VzBoT3D/VzBoT-Vz235/README.md

# VzBoT-Vz235

The Vz-235 is a smaller sized VzBoT with a bed print size of 235 x 235 and a Z of 200-225 mm depending on your hotend length and an optional AWD setup, for which we named the Kinematics "QuadXY" (also known as AWD).

You can find the complete web model without CAD-Software here:

- [Printed Vz-235](https://a360.co/4ig13Yv)
- [CNC Full Mellow kit](https://a360.co/3DxAVt8) 

## Purchase

AWD kit by Mellow3D: [Mellow Genuine DIY VzBoT AWD 235 VZ235 3D Printer Kit](https://s.click.aliexpress.com/e/_DldJGNB)

The AWD version has been proven to be great for high speed printing without loss of quality!

VZ_235_QuadXY

## Support

Discord Invite (https://discord.gg/KWZWvCMxCq)

## License

This project is licensed as Creative Commons Attribution-NonCommercial 4.0 International (CC BY-NC 4.0)
(https://creativecommons.org/licenses/by-nc/4.0/)
