VzBoT3D/VzBoT-Vz235/Resellers/README.md

List of resellers (this will be updated as we will deploy elwhere)

## Europe:

## Europe:

- Danemark: [3DO.eu](https://3do.eu/) 
- Germany: [CR-3D.de](https://www.cr3d.de/)
- Germany: [Meltbro](https://meltbro.de)
- Poland: [X3Dshop](https://x3dshop.com/)

## Australia:
- [raven3dtech.com.au](https://raven3dtech.com.au)

## Canada:
- [Northprint3d.ca](https://northprint3d.ca/product/vzbot-mellow-goliath-lsd-hotend/)

## USA:
- [Provok3D](https://provok3d.com/vzbot-2/?v=0a10a0b3e53b)
- [3Dprintedprinter](https://3Dprintedprinters.com) 
- [Genericprinter](https://www.genericprinter.com/)
- [Print3Dshop.org](https://print3dshop.org/)
- [Fabreeko](https://www.fabreeko.com/collections)

## More to come..
