VzBoT3D/VzBoT-Vz235/CAD/water pump-reservoir 150mm mount/README.md

BOM:

-8 x M4 12mm socket head
-4 x M4 Nut
-Elastic rope https://amzn.to/3NckYsY
- 150mm Water reservoir-pump kit Mellow: https://s.click.aliexpress.com/e/_DmlQsNr

  (Note that the 150mm might be unavailable, Mellow will add it back)

water_pump_mount_2023-Jun-21_02-46-15PM-000_CustomizedView52559326699
40250daa-644c-45b9-bb69-b60e7e664715
