VzBoT3D/VzBoT-Vz235/CAD/Screen Enclosure/Mellow-Fly Version/README.md

## Please note the USB-C port is not needed when connected with ribbon cable (DSI)



BOM:

- 4 x 6mm M3 bolts
- 1 x 25mm M4 bolts (for the hinge)
- 1 x M4 nut
- 2 x M4 8mm bolt (to bolt to frame)
- 2 M4 T-nuts
- Screen : https://s.click.aliexpress.com/e/_DDhO8jX
