VzBoT3D/VzBoT-Vz235/CAD/Pannels/Panels DXF/README.md

Panels for vz235 both AWD and 2WD, will work with both printed and alu parts
