VzBoT3D/VzBoT-Vz235/CAD/Electronic/Cam mounts/IMX179/README.md

BOM:

- 4 x M2.5 10mm
- 2 x M4 10mm
- 2 x M4 t-nuts
- Cam: https://www.welectron.com/Waveshare-USB-Camera-A-IMX179-8MP-HD-Embedded-Mic
