VzBoT3D/VzBoT-Vz235/Assemblies & STL/Electronics/Cam mount/HBVCAM-F20216HD/README.md

HBVCAM-F20216HD 2MP 
CAM [here](https://amzn.to/3bjp0RK) 

The Camera has a Field of View (FOV)：136°  ultra wide angle

Mainsail config: camera_usb_options="-r 1920x1080 -f 3 -q 100"

BOM: 4x M2 10mm + 2xM4 8mm + 2 tnuts 
