VzBoT3D/VzBoT-Vz235/CAD/Electronic/Cam mounts/Arducam UC-626/README.md

Arducam UC-626 with Sony 8MP IMX219
CAM [here](https://www.uctronics.com/camera-modules/usb-uvc-camera-module/arducam-8mp-1080p-usb-camera-module-1-4-cmos-imx219-mini-uvc-usb2-0-webcam-board-with-1-64ft-0-5m-usb-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) or [here](https://amzn.to/3O8LiDR) on Amazon Canada 

The Camera has a Field of View (FOV)：H=62.2°, V=48.8°  which is not ultra wide angle, so once you switch to 1080, its not wide enough. It works good with 720p, but still would be better with wider FOV

I suggest trying this one that should fit in same case. But cover might need to be redesigned for the front hole
https://www.uctronics.com/arducam-8mp-imx179-150-wide-angle-m12-lens-camera-module.html
