VzBoT3D/VzBoT-Vz235/Gallery/README.md

DSC05306 (Large)
DSC05307 (Large)
DSC05308 (Large)
DSC05309 (Large)
DSC05310 (Large)
DSC05311-Edit (Large)
DSC05313 (Large)
DSC05315 (Large)
DSC05316 (Large)
DSC05319 (Large)
DSC05320 (Large)
DSC05321 (Large)
DSC05322 (Large)
DSC05326 (Large)
DSC05331-Edit (Large)
DSC05332 (Large)
DSC05334 (Large)
DSC05339 (Large)
DSC05343 (Large)
DSC05344 (Large)
DSC05345 (Large)
DSC05346 (Large)
DSC05380 (Large)
DSC05381 (Large)
DSC05382 (Large)
DSC05383 (Large)

Vz235-gantry-printed
Vz235-gantry-printed
