VzBoT3D/VzBoT-Vz235/CAD/README.md

## Due to the large file sizes of .step files it is required to zip the files before uploading to github
After downloading the folder can be unpacked with 7-Zip (https://www.7-zip.org/)

For those not familiar with CAD software, we recommend using Fusion360 to open the step files
Do not feel intimidated by the sheer amount of parts or complexity
linked below are some video's to get started in Fusion360

https://www.youtube.com/watch?v=WBQFc_4rU18

https://www.youtube.com/watch?v=a5L55B5OCQM

https://www.youtube.com/watch?v=9Jgty4QDtss
