VzBoT3D/VzBoT-Vz235/Aluminum parts/README.md

# Aluminium parts 

## As available at https://f3d-racing-fdm.myshopify.com/collections/vzbot-vz235

Download the full manual, which includes BOM & print list for all aluminum goodness, above or download the per product manual

VZ-235_AWD gantry
