VzBoT3D/VzBoT-Vz235/Aluminum parts/Rear motormounts & Idlers AWD/README.md

# Rear motormounts/Idlers for AWD configuration

## ! for the AWD Idlers you will need misumi or comparable shoulder bolts with specific dimensions: 5mm diameter, 20mm length (shaft), 6mm M3 threading !

Correct shoulder bolts: https://nl.aliexpress.com/item/1005003611471729.html

the current (beta) units for this part as sold by F3D have the outer mounting hole intended for a M3 bolt instead of M4 like the mellow version (shown in picture)
this will be perfectly fine but be aware
