VzBoT3D/VzBoT-Vz235/Aluminum parts/Front motor mounts/README.md

# Front motor mounts for AWD and 2WD

For instructions, BOM and STL list: see the pdf manual above
