VzBoT3D/VzBoT-Vz235/Aluminum parts/Front motor mounts/STL's/readme.md

The printed motor anchor alu mount needs to be printed as it's imported
