VzBoT3D/VzBoT-Vz235/Assemblies & STL/Z-Assembly/parts to print 2 & 4 times/README.md

check the manual for the amount to print each part
