VzBoT3D/VzBoT-Vz235/Assemblies & STL/Gantry/Y gantry/Aluminum Y Gantry/BOM/README.md

# BOM is for one side only. You will need 2. 

### Your choice of precision shoulder bolts for Idlers, or M5 titanium or aluminum bolts with nuts. If you prefer weight saving go with bolts. If you prefer precision on idlers, go with shoulder bolts

## (Note: Since Carbon fiber tube dimensions are not always the same, you may need to add spacers (printed) between aluminum part and cabon tube. My tubes were 20.85mm and 20.65mm. I used the 20.85mm one with no washer. So depending on your luck, you may need to add spacers. See in the STL folder. you can scale it in Z in your slicer to fit your tube)

## When torquing the the idlers, make sure you do not apply to much axial load on the idler bearings. Tight manually with hands then add 1/4. Make sure idlers spin freely. This will avoid rattling sound, specially if you use graphite or metal spacers sold by mellow Kit)

(The below animation is from Vz330. Same instructions applies to Vz150 and 235, except for idlers orientation that is different. Smooth to the front and toothed to the back on the 150 and 235)
Y gantry aluminum v7

- (You might also take a look at this full gantry hardware kit https://s.click.aliexpress.com/e/_A0Qa7P)

| Quantity | Part | Comment | Image  | Links  |
| --- | ---- | --- | -----  | -----	|
| 4 | M3 10mm Bolts | | M3x10_sockethead	 | |
| 2 | M3 30mm Bolts | | M3x30_sockethead	 | |
| 2 | M3 Nuts | |	M3_Nut | |
| 2 | M5 30mm Bolts | Titanium | M5x30_sockethead  | https://s.click.aliexpress.com/e/_ABwfEB |
| 2 | M5 	  Nylon locking Nuts |	 | M5_Nylon_lock_Nut | |
| 2 | M4 Shoulder bolt 25mm + 2 M4 nuts| D5-M4 instead of the M5 Bolts. | | https://s.click.aliexpress.com/e/_DEXaIjF |
| 1 | 20teeth Gt2 pulley 5mm bore  | |Idler-20tooth GT2 6mm+5mm bore	 | https://s.click.aliexpress.com/e/_A79ECg |
| 1 | Noteeth Gt2 pulley 5mm bore  | |	 Idler-notooth GT2 6mm+5mm bore | https://s.click.aliexpress.com/e/_A79ECg |
| 1 | Aluminum Gantry | |	Alu gantry | https://s.click.aliexpress.com/e/_9Ghgwj |
