VzBoT3D/VzBoT-Vz235/BOM/README.md

# VzBoT-Vz235
# Work in progress, please tell us any errors
## https://docs.google.com/spreadsheets/d/1zm8jDL3NnV-vcbTjB-WAfdR3G6cT10QKlFqJNG42WAU/edit?usp=sharing

VZ_235_QuadXY
