VzBoT3D/VzBoT-Vz235/(list of files, cad)

Other CAD files:
Aluminum parts/Complete Z-system/STL-files/VZ_235_AWD_2WD_Z assembly allignment tool 10mm rods VZprinthead.stl
Assemblies & STL/Spool holder/main body.stl
Assemblies & STL/Z-Assembly/parts to print 2 & 4 times/upper rod mount main.stl
Assemblies & STL/Z-Assembly/parts to print 2 & 4 times/lower rod mount main.stl
Aluminum parts/Aluminium Y gantry/gantry_back_spacer.stl
Aluminum parts/Front motor mounts/STL's/left/printed standoff.stl
Aluminum parts/Front motor mounts/STL's/right/printed standoff.stl
Aluminum parts/Rear motormounts & Idlers AWD/STL's/spacer M3 corner.stl
Assemblies & STL/[Optional] Wall anchor/printer anchor frame side.stl
Assemblies & STL/CPAP turbo cooling system/STLs/CPAP back panel tube mount/optinal cap (need 18.2mm hole.stl
Assemblies & STL/CPAP turbo cooling system/STLs/CPAP Muffler/baffle.stl
Assemblies & STL/CPAP turbo cooling system/STLs/upper duct.stl
Assemblies & STL/Electronics/Cam mount/ArducamMount/enclosure.stl
Assemblies & STL/Electronics/Cam mount/HBVCAM-F20216HD/enclosure.stl
Assemblies & STL/Electronics/Cam mount/IMX179/cover.stl
Assemblies & STL/Electronics/Fly Super8/FlySuper8 fan cover.stl
Assemblies & STL/Electronics/Optional Front LED/Led mount.step
Assemblies & STL/Electronics/Screen Mount/Mellow-Fly Version/Front cover.stl
Assemblies & STL/Electronics/Screen Mount/screen cover.stl
Assemblies & STL/Enclosure/electronic back pack/knob backpanel.stl
Assemblies & STL/Enclosure/Front door latches/Locking latch/Lever top left and botttom right.stl
Assemblies & STL/Enclosure/Front door latches/Magnetic latch/Door latch mount.stl
Assemblies & STL/Enclosure/Fume extractor/fume extractor/fan guard.stl
Assemblies & STL/Enclosure/Hinges (lower)/hinges [lower]/hinge frame side.stl
Assemblies & STL/Enclosure/Misc/Door stopper.stl
Assemblies & STL/Enclosure/Misc/misc/Led strip holder [print in vase mode].stl
Assemblies & STL/Enclosure/Panels Trim pieces/panel corner piece.stl
Assemblies & STL/Enclosure/Topcover Latches/topcover latch/topcover holder top part 2.stl
Assemblies & STL/Enclosure/TPU Grommets (optional)/tpu grommets [optional]/Tpu optional grommet.stl
Assemblies & STL/FlowTest/Flowtest-0.5mmNozzle.stl
Assemblies & STL/Frame/Feet/STL/Spacer.stl
Assemblies & STL/Frame/Foot.stl
Assemblies & STL/Gantry/2WD idlers/PulleyMountLeftTop.stl
Assemblies & STL/Gantry/AWD A2B2 motormounts_idlers/AWDMountleftBottom.stl
Assemblies & STL/Gantry/Misc/Rear Belt clip.stl
Assemblies & STL/Gantry/Motormounts/left motormounts/top part motormount.stl
Assemblies & STL/Gantry/Motormounts/right motormounts/knob.stl
Assemblies & STL/Gantry/Motormounts/Supported Shaft Motor Mounts/Left Motormounts/Printed Standoff right.stl
Assemblies & STL/Gantry/Motormounts/Supported Shaft Motor Mounts/Right Motormounts/Printed Standoff right Mirrored.stl
Assemblies & STL/Gantry/Y gantry/Aluminum Y Gantry/STLs/gantry back spacer.stl
Assemblies & STL/Gantry/Y gantry/Printed Y Gantry/STLs/New Alu X Tube/Y_gantry_top_right.stl
Assemblies & STL/Spool holder/printed insert logo.stl
Assemblies & STL/Tools/PSU drilling stancil/PSU drilling stancil.stl
Assemblies & STL/Tools/Z allignment tool 10mm rod VZ235 VZ printhead.stl
Assemblies & STL/Z-Assembly/Oldham (printed)/Component1 (1) (1).stl
Assemblies & STL/Z-Assembly/parts to print 2 & 4 times/LM10LUU to LMK10LUU.stl
Assemblies & STL/Z-Assembly/parts to print once/Upper bracket single z motormount.stl
CAD/CPAP/Cpap back panel tube mount Vz235.step
CAD/CPAP/Cpap Muffler/CPAP Muffler.step
CAD/Detachable wall anchor.step
CAD/Electronic/Cam mounts/Arducam UC-626/Arducam-UC626 mount .step
CAD/Electronic/Cam mounts/HBVCAM-F20216HD/HBVCAM-F20216HD mount.step
CAD/Electronic/Cam mounts/IMX179/Waveshare_IMX179_Mount_v4.step
CAD/Electronic/FLy Super8 + 5160pro/Fly Super8 + 5160 HV .step
CAD/Front Doors locking latches/door latch.step
CAD/Pannels/Panels DXF/vz235 back Electronic panel.dxf
CAD/Pannels/panels.step
CAD/Screen Enclosure/Mellow-Fly Version/FLy-5inch LCD.step
CAD/Screen Enclosure/Screen enclosure.step
CAD/water pump-reservoir 150mm mount/water pump mount..step
Slicer/Theme/PrusaSlicer-SuperSlicer/bed_assembly/Vz235SlicerBedModel.stl
Aluminum parts/Complete Z-system/STL-files/printed z switch adapter.stl
Aluminum parts/Front motor mounts/STL's/left/printed standoff 2.stl
Aluminum parts/Front motor mounts/STL's/right/printed standoff_motor anchor.stl
Aluminum parts/Rear motormounts & Idlers AWD/STL's/Spacer long.stl
Assemblies & STL/CPAP turbo cooling system/STLs/c-clamp.stl
Assemblies & STL/CPAP turbo cooling system/STLs/CPAP back panel tube mount/Lower CPAP body.stl
Assemblies & STL/CPAP turbo cooling system/STLs/CPAP Muffler/Airbox.stl
Assemblies & STL/Electronics/Cam mount/ArducamMount/cover.stl
Assemblies & STL/Electronics/Cam mount/HBVCAM-F20216HD/cover.stl
Assemblies & STL/Electronics/Cam mount/IMX179/enclosure.stl
Assemblies & STL/Electronics/Fly Super8/FlySuper8+4x5160pro mount.stl
Assemblies & STL/Electronics/Screen Mount/Mellow-Fly Version/Back cover.stl
Assemblies & STL/Electronics/Screen Mount/screen back.stl
Assemblies & STL/Enclosure/electronic back pack/powerswitch bracket(Mirror).stl
Assemblies & STL/Enclosure/Front door latches/Locking latch/Door latch body bottom left.stl
Assemblies & STL/Enclosure/Front door latches/Magnetic latch/Door latch top right.stl
Assemblies & STL/Enclosure/Fume extractor/fume extractor/exhaust fan housing.stl
Assemblies & STL/Enclosure/Hinges (lower)/hinges [lower]/door side.stl
Assemblies & STL/Enclosure/Misc/misc/reverse bowden holder.stl
Assemblies & STL/Enclosure/Panels Trim pieces/panel middle piece.stl
Assemblies & STL/Enclosure/Topcover Latches/topcover latch/topcover holder top part.stl
Assemblies & STL/Enclosure/TPU Grommets (optional)/tpu grommets [optional]/stepper cable grommet.stl
Assemblies & STL/FlowTest/Flowtest-1.0mmNozzle.stl
Assemblies & STL/Frame/Feet/STL/foot.stl
Assemblies & STL/Frame/Frame brace.stl
Assemblies & STL/Gantry/2WD idlers/PulleyMountLeftBottom.stl
Assemblies & STL/Gantry/AWD A2B2 motormounts_idlers/AWDMountleftTop.stl
Assemblies & STL/Gantry/Misc/Rear Belt clip cover.stl
Assemblies & STL/Gantry/Motormounts/left motormounts/Motor plate.stl
Assemblies & STL/Gantry/Motormounts/right motormounts/cap.stl
Assemblies & STL/Gantry/Motormounts/Supported Shaft Motor Mounts/Left Motormounts/Printed Standoff left.stl
Assemblies & STL/Gantry/Motormounts/Supported Shaft Motor Mounts/Right Motormounts/Printed Standoff left Mirrored.stl
Assemblies & STL/Gantry/Y gantry/Aluminum Y Gantry/STLs/11mm M5 spacer.stl
Assemblies & STL/Gantry/Y gantry/Printed Y Gantry/STLs/New Alu X Tube/Y_gantry_top_left.stl
Assemblies & STL/RSCS V2/Mid part V2.stl
Assemblies & STL/Tools/100GramDrillJiggVZ235.stl
Assemblies & STL/Z-Assembly/Oldham (printed)/Component3.stl
Assemblies & STL/Z-Assembly/parts to print 2 & 4 times/one piece bed support v1.stl
Assemblies & STL/Z-Assembly/parts to print once/Lower Bracket single z motormount.stl
CAD/CPAP/printhead fan ducts and mount.step
CAD/Pannels/Panels DXF/vz235 back panel alu.dxf
CAD/VZspooldholder.step
Aluminum parts/Complete Z-system/STL-files/Z-chain mount.stl
Aluminum parts/Front motor mounts/STL's/left/front plate alu motormount.stl
Aluminum parts/Front motor mounts/STL's/right/front plate alu motormount.stl
Aluminum parts/Rear motormounts & Idlers AWD/STL's/spacer short top.stl
Assemblies & STL/CPAP turbo cooling system/STLs/CPAP back panel tube mount/Upper Cpap body.stl
Assemblies & STL/CPAP turbo cooling system/STLs/lower duct tri-horn.stl
Assemblies & STL/Electronics/Fly Super8/FlySuper8 din mountX2.stl
Assemblies & STL/Electronics/Screen Mount/Mellow-Fly Version/screen mount frame.stl
Assemblies & STL/Enclosure/electronic back pack/powerswitch bracket (1).stl
Assemblies & STL/Enclosure/Front door latches/Locking latch/Latch top right and bottom left.stl
Assemblies & STL/Enclosure/Front door latches/Magnetic latch/Door latch bottom left.stl
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
