VzBoT3D/VzBoT-Vz235/Assemblies & STL/Z-Assembly/README.md

For full Z CNC kit, If you want to re-use your old LM10LUU bearings and not buy LMK10LUU, you can print this [adapter](https://github.com/VzBoT3D/VzBoT-Vz235/blob/main/Assemblies%20%26%20STL/Z-Assembly/parts%20to%20print%202%20%26%204%20times/LM10LUU%20to%20LMK10LUU.stl) found in the STL folder
