VzBoT3D/VzBoT-Vz235/Assemblies & STL/VZ printhead/README.md

# VZprinthead is moved to it's own repository

https://github.com/VzBoT3D/Vz-Printhead-Printed
