VzBoT3D/VzBoT-Vz235/Assemblies & STL/Tools/PSU drilling stancil/README.md

If your back pannel is missing the PSU mouting holes, or if you are self making it, you can use this stancil to drill the holes.
- Align it with the central pannel mounting hole.
- Reverse the stancil for the other side and keep the "TOP" pointing to the top.
