VzBoT3D/VzBoT-Vz235/Assemblies & STL/Enclosure/TPU Grommets (optional)/README.md

# TPU Grommets

## the TPU grommets are optional pieces meant to be inserted in the holes in the back panel as sold by F3D & Mellow to prevent wires from pinching and wearing.
