VzBoT3D/VzBoT-Vz235/Assemblies & STL/Enclosure/Panels Trim pieces/README.md

# trim pieces

There is 2 trim loadouts available in the main CAD

Loadout 1 is covered in the manual as it is the hardest to install

the version F3D and Mellow sell are meant for Loadout 2 which is the default and the easyest to mount as shown below
