VzBoT3D/VzBoT-Vz235/Assemblies & STL/Gantry/Motormounts/Supported Shaft Motor Mounts/Readme.md

For the back motor mounts the old printed parts can be reused.

All the hardware needed for the Front and Back motor mounts.

| Quantity | Part | Image | comment  | Links  |
| --- | ---- | --- | ----- | -----	|
| 4 | F695ZZ Bearing | | Flanged bearing for holding motor shaft| |
| 4 | ISO 7380 M3x20 | | M3x20mm Button Head Hex drive Bolts | |
| 2 | ISO 7380 M4x20 | | M4x20mm Button Head Hex drive Bolts | |
| 6 | ISO 7380 M3x8  | | M3x8mm Button Head Hex drive Bolts | |
| 4 | ISO 7380 M4x16 | | M4x16mm Button Head Hex drive Bolts | |
| 4 | ISO 7380 M3x12 | | M3x12mm Button Head Hex drive Bolts | |
| 6 | ISO 7380 M3x6  | | M3x6mm Button Head Hex drive Bolts | |
| 2 | ISO 7380 M3x25 | | M3x25mm Button Head Hex drive Bolts | |
| 12 | ISO 7380 M4x8 | | M4x8mm Button Head Hex drive Bolts | |
| 4 | ISO 7380 M3x45 | | M3x45mm Button Head Hex drive Bolts | |
| 2 | ISO 7380 M4x10 | | M4x10mm Button Head Hex drive Bolts | |
| 4 | DIN 7991 M3x10 | | M3x10mm Countersunk socket head | |
| 2 | DIN 7991 M4x8  |  | M4x8mm Countersunk socket head | |
| 2 | DIN934 M4 Nut  |  | M4 Nuts | |
| 8 | DIN934 M3 Nut  |  | M3 Nuts | |
| 4 | M3 Standoff M3x25 | | 25mm long hex M3 standoffs | |
