VzBoT3D/VzBoT-Vz235/Assemblies & STL/Enclosure/Front door latches/Locking latch/README.md

BOM Needed:

- 4 x M3 10mm  (To lock levers to latches)
- 4 x M3 8mmm (To bolt to front door panels)
-  4 x M3 heat inserts 
