VzBoT3D/VzBoT-Vz235/Assemblies & STL/CPAP turbo cooling system/STLs/CPAP Muffler/README.md

BOM Needed:

- 2 x M3 10mm (to bolt airbox to CPAP fan)
- 1 X M3 6mm (to bolt baffle to airbox)
- 1 X M3 Heat insert 4.6x5mm
