VzBoT3D/VzBoT-Vz235/Assemblies & STL/[Optional] Wall anchor/README.md

# Wall Anchor

The wall anchor is meant as an addition for those daring to go full unicorn speed. 
Wall anchors are proven to reduce the amplitude of resonance and keep the printer stable

unknown (1)

unknown
