VzBoT3D/VzBoT-Vz235/(threads)

Thread 1 (2022-05-02):

Hole misalignment Foot and bottom panel

CrossCAD, 2022-05-02:
The distance from the center M5-M6 foot hole to the side M4 holes are not symmetric.

One is 32.5 mm, the other is 32.56 mm.

It's a very slight misalignment but one that was probably missed because the feet were mirrored.

Hence 2 feet fit perfectly but the other would be slightly misaligned.

Guillaume452, 2022-06-20:
thanks this will be fixed in the latest cad!

Closed 2022-06-20.

Thread 3 (2022-05-13):

Request to update the STL Folder to "voron style"

waym99, 2022-05-13:
What is meant by that is to reorganize the way stl are stored and named.

The voron team uses following convention for stl file naming
- A number at the end of each file name for indicating how often the part must be printed (no number = print it once).
- The [A] tag at the beginning of a file name means that this is an accent part
- All parts are already oriented for the best printing position

If we could get that implemented it would make printig parts much easier and more organized.

I know it's propably a lot of work. Specially to determine what printing position is the "best" but I think in the long run the vzbot community will really profit from that.

Guillaume452, 2022-06-20:
We will look into this. print orientation is no issue since all parts are designed to be printed easily with little to no supports. the numbering and altering the manual is another story.

Closed 2022-06-20.

Thread 4 (2022-06-07):

Request: 10 mm belt size

rockydubb, 2022-06-07:
Hi, is there a AWD "QuadXY" version but for a 10mm belt? I already have my setup with 10 mm belts and pulleys and really dont want to switch to the smaller 6 mm belt size ... thanks.

Guillaume452, 2022-06-20:
hmm do you have a 10mm version of a vzbot? currently 10mm version is not supported on both vz330 as vz235. this might be something we will have in the future but for now this will not be added I am affraid.

Closed 2022-06-20.

Thread 5 (2022-06-29):

Enclosure Panel DXF and hole sizes

CrossCAD, 2022-06-29:
I just sent out my enclosure panels to get fabricated and noticed that I could not find any pre-generated DXF files for the panels.
It would be nice to have those files to help people that don't have access to F360 or other CAD programs.

I suggest the DXF files should also have their own folder to make them easy to find.  A readme with recommended materials and thicknesses for the panels would be good also.

As far as the panels themselves, it would good for the simple panels to only use 1 drill size for consistency.  This will make it easier for those who wish to cut and drill their panels by hand.  I suggest 3.2mm as the size.  Here is why:  in the US and Canada 0.125 inch is smallest router bit many shops will have.  This will make it easier for to get sourced and tolerances on panels are not critical.

Guillaume452, 2023-02-23:
dxf files are added for the latest release:)

Closed 2023-02-23.

Thread 6 (2023-04-10):

Shoulder bolt standard

tomas789, 2023-04-10:
I had a problem with shoulder bolt. I was trying to order them locally but I was struggling a lot. They have a very specific name here. But there is a norm that they correspond to it is ISO 7379. When searching for this I was able to source it quite fast. It might be beneficial for others to also include those standards where possible.

Btw I think that the M4 variant is actually no in the norm. Somebody said that the norm is only from M5 but manufacturers somehow extrapolated the M4 variant too.

Closed 2025-01-02.

Thread 7 (2023-04-10):

Shoulder bolt replacement

tomas789, 2023-04-10:
I'm building the AWD version of 235. The rear motor holders use shoulder bolts for the timing belt guidance hardware. Those bolts are kinda PITA. The gantry uses just regular screws for mounting the same kind of hardware. Maybe the shoulder bolts could be replaced with M5 bolts. That would be much easier to source and would require only a small modification to the printed parts.

Guillaume452, 2023-06-20:
we had normal M5 in the past I could upload those files? those were replaced for shoulder bolts as we had found those to give less print artefacts

Closed 2025-01-02.

Thread 8 (2023-08-18):

CAD Model full CNC

Malvus524, 2023-08-18:
I can not find a downloadable CAD Model of the CNC Version.

Is this on purpose?

I am an trainee machinist and it would be really great if i could machine the parts by myself.

Anyways thanks a lot for the whole effor you guys a putting in to the community.

HumbleDeer, 2023-10-13:
The CNC parts are a collaboration between us, the manufacturers, and some other people who helped out with designing them. Their part files aren't available for download as these parts are currently exclusive to our partnered suppliers. :)

There is a CAD model viewable through Autodesk's online Fusion viewer; link is on the readme.

Closed 2023-10-13.

Thread 16 (2024-01-30):

Fume extractor CAD

Rom4ik-glitch, 2024-01-30:
is it possible to upload step file of fume extractor assembly?

Thread 17 (2024-11-30):

LED strip holder file doesn't work

Scootworks, 2024-11-30:
This file doesn't work: Assemblies & STL/Enclosure/Misc/misc/Led strip holder [print in vase mode].stl

The file cannot be opened or downloaded.

Thread 22 (2025-02-28):

Broken CAD links in README

andersevenrud, 2025-02-28:
Hi,

The links to the Fusion 360 CAD in the README are currently broken and gives:

```
Unauthorized

Sorry. You don't have permission to access this page.
```

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

---

Relevant links:

- [Printed Vz-235](https://a360.co/4b649fb)
- [CNC Full Mellow kit](https://a360.co/413FZyc)

andersevenrud, 2025-03-28:
This seems to have been solved in https://github.com/VzBoT3D/VzBoT-Vz235/commit/aa43438fcbf4167d35ce81c1b28bf49a9c417d38

Closed 2025-03-28.
