VzBoT3D/VzBoT-Vz235/(commit log)

2022-03-02 Create Assemblies_STL
2022-03-08 Delete assemblies_stl.zip
    reupload
2022-03-08 Add missing bed M3 support file
2022-03-13 Add files via upload
    added new cable holder - old one touched the belt on 2WD
2022-03-13 Add files via upload
    added new cable holder stl
2022-03-15 Add files via upload
    repaired non manifold stl file
    [bottom_piece.stl]
2022-03-15 Add files via upload
    repaired non manifold rscs bottom piece stl
2022-03-16 altered motormount
    removed redundant reinforcement in front motormount tensioner plate
2022-03-16 Add files via upload
    updated motormount bom + renders
2022-03-16 Add files via upload
    changed motormount tensioner plates
2022-04-17 Adding wiring diagram
2022-04-25 fixed wiring diagram for Bed sensor connection
2022-04-26 Create STL-Files
2022-05-02 LM10LUU bracket tighter to 19.2mm
    [lead screw + lm10luu bracket one piece.stl, lm10luu bracket.stl]
2022-05-05 Add files via upload
    updated: z parts for better fit around t nuts
    updated: RSCS Fitment
    Updated: added 19.2mm LM10LUU brackets
2022-05-05 Add files via upload
    updated:
    RSCS
    Z Assembly
2022-05-05 Add files via upload
    updated: fitment around t nuts
    [Lead Screw lower bracket.stl, Lead Screw upper bracket.stl, lower rod mount main.stl, upper rod mount main.stl]
2022-05-25 Adding Fly Super8 board mount
    [FlySuper8 din mountX2.stl, FlySuper8 fan cover.stl, FlySuper8+4x5160pro mount.stl]
2022-06-01 Add files via upload
    added an optional step for the alu printhead in bed allignment
2022-06-01 Add files via upload
    added z allignment tool for alu printhead config
2022-06-01 Add files via upload
    updated bed position and z allignment tool, moved the bed to fit the alu printhead
2022-06-01 Create Cpap back panel tube mount Vz235.step
    [Cpap back panel tube mount Vz235.step]
2022-06-01 Adding CPAP CAD
    [CPAP fan mount.step, CPAP fan outlet adapter.step, printhead fan ducts and mount.step]
2022-06-01 CPAP STL added
    [CPAP fan mount.stl, CPAP fan outlet adapter.stl, Lower CPAP body.stl, Upper Cpap body.stl, c-clamp.stl, lower duct tri-horn.stl, optinal cap (need 18.2mm hole.stl, upper duct mount.stl]
2022-06-06 Update Cpap back panel tube mount Vz235.step
    Added the aluminum back plate to have the hole measurement and placement
    [Cpap back panel tube mount Vz235.step]
2022-06-13 Create VeZ_back electronic_bay.step
    [VeZ_back electronic_bay.step]
2022-06-19 wiring diagram needs update
2022-06-19 Adding Arducam mount
    [cover.stl, enclosure.stl]
2022-06-20 Add files via upload
    adjusted awd motormounts to tighter tolerances for the m4 nuts
2022-06-20 updated awd motormounts
    tighter tolerances on M4 nut pockets
2022-06-20 updated tolerances of M4 nut pockets
    [PulleyMountRightBottom.stl, PulleyMountleftBottom.stl]
2022-06-20 Create Arducam-UC626 mount .step
    [Arducam-UC626 mount .step]
2022-06-22 Adding FlowTest stl
    [Flowtest-0.4mmNozzle.stl, Flowtest-0.5mmNozzle.stl, Flowtest-0.6mmNozzle.stl, Flowtest-0.8mmNozzle.stl, Flowtest-1.0mmNozzle.stl]
2022-06-24 Added M3 misumi version for AWD motormounts
2022-06-24 Create M3 Misumi Shoulder bolt version
2022-06-24 Add files via upload
    Added M3 misumi shoulder bolt option for rear motormounts, same as Alu version
    [PulleyMountLeftBottom M3.stl, PulleyMountRightBottom M3.stl, PulleyMountRightTop M3.stl, PulleyMountleftTop M3.stl]
2022-06-24 Fixed minor allignment error in front panel holes
2022-07-04 Added Vez Firmware Super 8
    [Frame brace.stl, printer-VEZ.cfg, vz235AWD.cfg]
2022-08-02 Adding support for HBVCAM-F20216HD camera
    [HBVCAM-F20216HD mount.step]
2022-08-02 adding HBVCAM-F20216HD v2 cam support
    [cover.stl, enclosure.stl]
2022-08-04 Update top piece.stl
    [top piece.stl]
2022-08-08 Added CPAP intake fan hole to back aluminum plate
    In the Vez's back pack CAD file.
    [VeZ_back electronic_bay.step]
2022-08-31 fixed a small issue on Printed Y gantry bottom part.
    The bottom right hole for the MGN12 block had a missing fillet/radius
    [gantry bottom.stl]
2022-08-31 changed the top duct to fit better between the upper rod mounts to get the rscs lower for the length of the LSD44
2022-09-09 Adding Pannels Step
    [panels.step]
2022-09-13 adding Superslicer bed model
    [SlicerBedModel.stl, Vz235SlicerBedModel.stl]
2022-09-20 Add files via upload
    mandatory low profile idlers added
2022-09-20 Add files via upload
    added note to mandatory low profile idlers
2022-10-03 updated Super8 mount
    Holes for the 5160's updated for the V1.2
    [Fly Super8 + 5160 HV .step, FlySuper8 fan cover.stl, FlySuper8+4x5160pro mount.stl]
2022-10-09 Create Led mount.step
    [Led mount.step]
2022-10-09 Create Led mount.stl
    [Led mount.stl]
2022-10-18 Create Detachable wall anchor.step
    [Detachable wall anchor.step]
2022-10-21 Fixed Super8 Fan cover
    [Fly Super8 + 5160 HV .step, FlySuper8 fan cover.stl]
2022-11-21 adding new screen enclosure
    [Front Screen Cover.stl, Rear Screen Cover PiTFT5 version 1.stl, Rear Screen Cover PiTFT5 version 2.3mf, Rear Screen Cover PiTFT5 version 2.stl, screen back X2.stl, screen cover.stl, screen mount back.stl, screen mount frame.stl]
2022-11-21 adding screen enclosure cad
    [Screen enclosure.step, screen back.stl]
2022-11-21 updated screen enclosure
    [screen back.stl, screen cover.stl]
2022-11-21 Update Screen enclosure.step
    [Screen enclosure.step]
2022-11-21 update screen enclosure
    [screen back.stl, screen cover.stl]
2022-11-22 fixing small issue with screen enclosure
    [Screen enclosure.step, screen cover.stl]
2022-12-15 Update Upper bracket single z motormount.stl
    [Upper bracket single z motormount.stl]
2023-01-07 Added printed web viewer
2023-02-09 adding locking latches
    [Door latch body bottom left.stl, Door latch body bottom right.stl, Door latch body top left.stl, Door latch body top right.stl, Door latch bottom left.stl, Door latch bottom right.stl, Door latch mount.stl, Door latch top left.stl]
2023-02-09 adding cad front door lock latches
    [door latch.step]
2023-02-10 adding IMX179 cam mount option
    [Arducam-UC626 mount .step, Fly Super8 + 5160 HV .step, HBVCAM-F20216HD mount.step, Waveshare_IMX179_Mount_v4.step]
2023-02-10 Adding IMX179 STL file (cam mount)
    [cover.stl, enclosure.stl]
2023-02-10 Add files via upload
    replaces leadscrew support and lmk10uu bracket. slimmer bracket to fit RSCS V2
    [one piece bed support v1.stl]
2023-02-13 Add files via upload
    V2.0 cad
2023-02-13 Panels update. Back alu panel and side panels
    -back: Adding holes to mount PSUI
    -Sides: Adding holes to mount RSCS adjustable height
    [VZ235 left panel acrylic 3mm.dxf, vz235 back Electronic panel.dxf, vz235 back panel alu 4mm.dxf, vz235 back panel alu.dxf, vz235 bottom panel alu 4mm.dxf, vz235 bottom panel alu.dxf, vz235 front left panel 3mm.dxf, vz235 front left panel acrylic 3mm.dxf]
2023-02-23 Add files via upload
    fixed some printability issues with overhangs
    [Mid part V2.stl, Top part V2.stl]
2023-02-27 Add files via upload
    fix small tolerance error
    [Mid part V2.stl]
2023-03-10 Create LM10LUU to LMK10LUU.stl
    [LM10LUU to LMK10LUU.stl]
2023-03-22 Delete Assemblies & STL/RSCS directory
    rscs deprecated, rscsV2 fully tested
    [bottom_piece.stl, middle piece.stl, top piece.stl]
2023-03-28 adding Y aluminum STL section
    [1.4mm M5 spacer.stl, 11mm M5 spacer.stl, XendStop.stl, Y_gantry_bottom_left.stl, Y_gantry_bottom_right.stl, Y_gantry_top_left.stl, Y_gantry_top_right.stl, gantry back spacer.stl]
2023-03-28 Add files via upload
    new y gantry brackets
2023-03-28 update to wiring diagram
    1-Adding 24v to 48v DC neg between PSU
    2-Moving 48V driver bank from 4-7 to 3-6.
2023-03-28 update to firwmare
    [235AWD-printer.cfg, vz235AWD.cfg]
2023-04-04 Update AWD MELLOW FLY SUPER 8 WITH CPAP.png
    bed thermistor was going to the wrong port
2023-05-10 adding Mellow-Fly LCD enclosure
    [Back cover.stl, Front Screen Cover.stl, Front cover.stl, Rear Screen Cover PiTFT5 version 1.stl, Rear Screen Cover PiTFT5 version 2.3mf, Rear Screen Cover PiTFT5 version 2.stl, screen back.stl, screen cover.stl]
2023-05-19 Fixing holes on the back panels for PSU mounting
    holes were M3 and the PSU is M4. Switched to 4.3mm
    [vz235 back Electronic panel.dxf, vz235 back panel alu.dxf]
2023-05-24 Create Door stopper.stl
    [Door stopper.stl]
2023-05-29 Update Front cover.stl
    [Front cover.stl]
2023-06-12 Update AWD MELLOW FLY SUPER 8 WITH CPAP.png
    -changed CPAP wiring to PF8 pin on super8
    -Added ground to SSR heater for those who dont use DIN rail
    -Added thermal fuse to bed for those who don't use Mellow bed heater with built-in thermal fuse
2023-06-12 firmware files updated
    -Printer.cfg updated to have CPAP pin on PF8 on super8
    -firmware bin file updated to have pin PF8 disabled at boot up or when klipper is not running
    [235AWD-printer.cfg]
2023-06-14 Adding CPAP Muffler
    [Airbox.stl, CPAP Muffler.step, baffle.stl]
2023-06-21 adding Watercool pump mount
    [Airbox.stl, CPAP Muffler.step, baffle.stl]
2023-06-21 Create water pump mount..step
    [water pump mount..step]
2023-06-21 Create CPAP Muffler.step
    [CPAP Muffler.step]
2023-06-21 moving watercool mount directory to CAD
    [water pump mount..step]
2023-06-23 Create PSU drilling stancil.stl
    [PSU drilling stancil.stl]
2023-06-28 re-adding CPAP Muffler
    for some reason it got deleted
    [Airbox.stl, baffle.stl]
2023-07-14 re-uploading Cpap muffler STL's
    files were broken
    [Airbox.stl, baffle.stl]
2023-07-15 update Mellow FLy 5" screen mount
    [Back cover.stl, Front cover.stl]
2023-07-15 adding mellow fly LCD mount cad
    [FLy-5inch LCD.step, Screen enclosure.step]
2023-07-17 update to Mellow Fly 5" screen enclosure (front only)
    [FLy-5inch LCD.step, Front cover.stl]
2023-08-20 Update 235AWD-printer.cfg
    Making docs/github the same.
    [235AWD-printer.cfg]
2023-08-20 update wiring diagram.
2023-08-21 adding Macro files.
    [235AWD-printer.cfg, Exclude_Object.cfg, Macro.cfg, Speed.cfg, Start_Stop.cfg]
2023-08-21 Update on the front motor standoffs on the frame side
    The new standoff will make it easier to route belts. This update does not change anything else.
    [printed standoff.stl]
2023-08-24 adding frame feet assembly and BOM info
    [Spacer.stl, foot.stl]
2023-09-01 Delete Assemblies & STL/Gantry/AWD A2B2 motormounts_idlers/M4 Shoulder bolt version directory
    deprecated
    [PulleyMountRightBottom M4.stl, PulleyMountRightTop M4.stl, PulleyMountleftBottom M4.stl, PulleyMountleftTop M4.stl]
2023-09-01 Add files via upload
    updated AWD mounts minor fixes
2023-09-15 Update FlY SUPER 8 WIRING DIAGRAM AWD WITH CPAP.png
    matched color code for5160 drivers from board to super8 and to motors
2023-09-19 update to wall anchors
    the original version was interfering with CPAP
    [printer anchor frame side (1).stl, printer anchor frame side.stl]
2023-10-05 Update FlY SUPER 8 WIRING DIAGRAM AWD WITH CPAP.png
2023-11-20 Update 235AWD-printer.cfg
    Enable Arc support for Orcaslicer
    [235AWD-printer.cfg]
2024-01-31 new printed Y gantry for Alu X tube.
    Fixed spacing from 20.2mm to 21.2mm for the new Alu X Tube.
    [Y_gantry_bottom_left.stl, Y_gantry_bottom_right.stl, Y_gantry_top_left.stl, Y_gantry_top_right.stl]
2024-04-24 Update Start_Stop.cfg
    changed M106 S0 to M107
    [Start_Stop.cfg]
2025-01-01 match default klipper path
    The default Klipper path for the virtual_sdcard is ~/printer_data/gcodes, so we will use that original path to prevent users from becoming confused.
    [235AWD-printer.cfg]
2025-02-06 Update README.md
    fixed online CAD url
2025-05-15 Files + BOM for supported Shafts.
    [Printed Standoff back Mirrored.stl, Printed Standoff back.stl, Printed Standoff left Mirrored.stl, Printed Standoff left.stl, Printed Standoff right Mirrored.stl, Printed Standoff right.stl]
2025-05-15 added BOM
2025-09-25 Create optional nut retainer.stl
